JamesNewton/HybridDiskEncoder/firmware/readme.md

Hybrid Encoder Firmware

Ver 0.1 Connect via serial terminal 115,200 N81, 
 - 's' shows sin, cos, and ATAN2
 - '8' sin LED drive up '2' sin LED drive down
 - '6' cos LED drive up '4' cos LED drive down

TODO: Setup a timer and just output ATAN2 regularly
