JamesNewton/HybridDiskEncoder/docs/AreaRectCircle.png

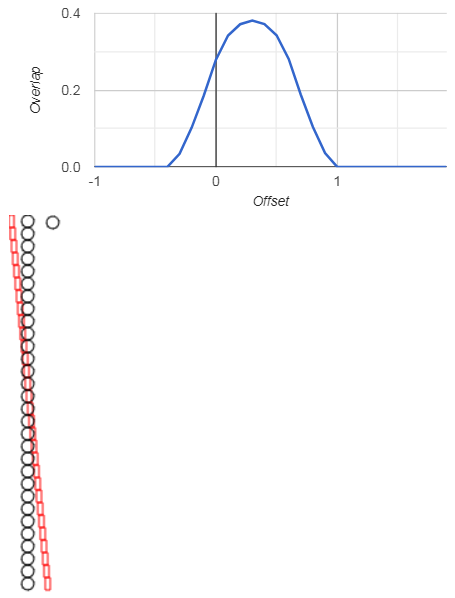
docs/AreaRectCircle.png
