JamesNewton/HybridDiskEncoder/(threads)

Thread 1 (2018-12-03):

Need to compute the arc tangent of the sensor inputs.

JamesNewton, 2018-12-03:
Possible guide
http://www.coranac.com/documents/arctangent/

JamesNewton, 2019-11-04:
http://scolton.blogspot.com/2019/09/fast-atan2-alternative-for-three-phase.html

JamesNewton, 2024-10-25:
Done for now with the standard math.h atan2 which seems to work fast enough. If we need more speed in the future, we can revisit.
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

JamesNewton, 2024-10-25:
Better scaling of the output
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

Closed 2024-10-25.

Thread 3 (2019-02-20):

Rectangular slits make square eyes, not round.

JamesNewton, 2019-02-20:
So the point of this is to get a round "eye" or circle when you plot the two sensors as X and Y on a graph. But that requires that the two sensors each put out a sin wave. It turns out that when the mask and slots are both rectangles, the resulting waveform is more of a triangle or a trapezoid, depending on their relative size.

Fig. 1: Rectangle passing over rectangle.<br>
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

Fig. 1: Rectangle passing over circle.<br>
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

The question of what shape results when you plot the area of intersection between two shapes out of phase on X and Y graph was interesting so I wrote a program to simulate it:
https://stackblitz.com/edit/enc-slot-shape-area
(change the code in any way to reload if you get an error about google not being defined). It's a bit of a mess because I started with rectangular shapes only and then added support for polygons to approximate any shape.

It's node.js so here is the package.json file
````json
{
  "name": "enc-slot-shape-area",
  "version": "0.0.0",
  "private": true,
  "dependencies": {
    "google-charts": "2.0.0",
    "greiner-hormann": "1.4.1",
    "polygon-clipping": "^0.12.2"
  }
}
````

And the actual program, index.js
````javascript
// Import stylesheets
import './style.css';
import {GoogleCharts} from 'google-charts';
import polygonClipping from 'polygon-clipping'

const poly1 = [[[0,0],[2,0],[2,2],[0,2],[0,0]]]
const poly2 = [[[0.1,0],[2.1,0],[2.1,2],[0.1,2],[0.1,0]]]

console.log(polygonClipping.intersection(poly1, poly2 /* , poly3, ... */))

// Write Javascript code!
const appDiv = document.getElementById('app');
//appDiv.innerHTML = `<h1>JS Starter</h1>`;
GoogleCharts.load('current', {packages: ['corechart', 'line']});
var data = new google.visualization.DataTable();
data.addColumn('number', 'X');
data.addColumn('number', 'Area');
//      data.addColumn('number', 'Cats');

function areaOverlapRect(shape1, shape2, inc) {
  var l1x=shape1.x+inc
  var l1y=shape1.y
  var r1x=shape1.x+shape1.w+inc
  var r1y=shape1.y+shape1.h
  var l2x=shape2.x
  var l2y=shape2.y
  var r2x=shape2.x+shape2.w
  var r2y=shape2.y+shape2.h
  var width = Math.max(Math.min(r1x, r2x) - Math.max(l1x, l2x),0)
  var height = Math.max(Math.min(r1y, r2y) - Math.max(l1y, l2y),0)
  return  width * height;
  }

//Area of polygon
//https://www.mathopenref.com/coordpolygonarea2.html

//Intersection of 2 polygons
//https://github.com/mfogel/polygon-clipping
function areaOverlapPoly(shape1, shape2, inc) {
  var total = 0
  var poly = []
  shape1.points.forEach((e,i) => {poly.push([e[0]+inc,e[1]])})
  var clip = polygonClipping.intersection([poly], [shape2.points] )
  //console.log(clip)
  if (!clip.length) {
    console.log("no intersection")
    return 0
    }
  clip = clip[0][0] //polygon-clipping returns burried array
  for (var i = 0, l = clip.length-1; i <= l; i++) {
    var addX = clip[i][0];
    var addY = clip[i == l ? 0 : i + 1][1];
    var subX = clip[i == l ? 0 : i + 1][0];
    var subY = clip[i][1];

    total += (addX * addY * 0.5);
    total -= (subX * subY * 0.5);
    }
  //console.log(total)
  return Math.abs(total);
  }

function areaOverlap( shape1, shape2, inc) {
  if(shape1.type != shape2.type) {
    console.log("only support same type")
    return null
  }
  if(shape1.type == "rect") return areaOverlapRect( shape1, shape2, inc)
  if(shape1.type == "poly") return areaOverlapPoly( shape1, shape2, inc)
  }

function drawPolyAtScaleCanvas(poly, x, y, scale, ctx) {
  ctx.beginPath();
  ctx.strokeStyle = poly.color;
  ctx.moveTo(scale*poly.points[0][0]+x, scale*poly.points[0][1]+y)
    for (var i in poly.points) { //re-does point 0 but who cares?
      ctx.lineTo(scale*poly.points[i][0]+x, scale*poly.points[i][1]+y)
      }
  ctx.stroke();
  }

function drawRectAtScaleCanvas(rect, x, y, scale, ctx) {
  ctx.beginPath();
  ctx.strokeStyle = rect.color;
  ctx.moveTo(scale*rect.x+x, scale*rect.y+y);
  ctx.lineTo(scale*(rect.x+rect.w)+x, scale*rect.y+y);
  ctx.lineTo(scale*(rect.x+rect.w)+x, scale*(rect.y+rect.h)+y);
  ctx.lineTo(scale*rect.x+x, scale*(rect.y+rect.h)+y);
  ctx.lineTo(scale*rect.x+x, scale*rect.y+y);
  ctx.stroke();
  }

function drawShapeAtScaleCanvas( shape, x, y, scale, ctx) {
  if(shape.type == "rect") return drawRectAtScaleCanvas(shape, x, y, scale, ctx)
  if(shape.type == "poly") return drawPolyAtScaleCanvas(shape, x, y, scale, ctx)
  }

var c = document.getElementById("myCanvas");
var ctx = c.getContext("2d");

var shape1 = {x:0, y:0, h:1, w:.5, color: "red", type: "rect"}
var shape2 = {x:0, y:0, h:1, w:.2, color: "blue", type: "rect"}
var mask = 0.4
const poly = {points:[[0,0],[mask,0],[mask,1],[0,1],[0,0]], color:"red", type:"poly" }
var circles = {points:[], color:"black", type:"poly"}
for (var i = 0; i<Math.PI*2; i+=.5) {
  circles.points.push([(Math.cos(i)+1.001)/2,(Math.sin(i)+1.001)/2])
  }
circles.points.push(circles.points[0])
drawShapeAtScaleCanvas(circles, 30, 1, 10, ctx)
shape1 = poly
shape2 = circles
//console.log(areaOverlap( shape1, shape2, 0 ))
var viewScale = 10
var area
var line = 0
for (var i=-1; i<2; i+=0.1) {
  drawShapeAtScaleCanvas(shape1, (i+1)*viewScale, line*viewScale, viewScale, ctx)
  drawShapeAtScaleCanvas(shape2, 1*viewScale, line*viewScale, viewScale, ctx)
  line += 1
  area = areaOverlap( shape1, shape2, i )
  //console.log( Math.round(area*1000)/1000 )
  data.addRows([[i,area]])
  }
var chart = new google.visualization.LineChart(document.getElementById('chart1'));
var options = {
  hAxis: {
    title: 'Offset'
  },
  vAxis: {
    title: 'Overlap'
  },
  series: {
    1: {curveType: 'function'}
  }
};
chart.draw(data, options);
````

JamesNewton, 2023-02-28:
Actually, it turns out that a circle is not the ideal shape. It's much better, but not perfect. The perfect shape is actually sort of an inside out circle.

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

```js
var jw = { points: [], color: 'black', type: 'poly' };
for (var i = 0; i < Math.PI * 2; i += Math.PI / 8) {
  let x = i >= Math.PI ? Math.PI * 2 - i : i; //over to the right, then back
  x /= Math.PI * mask; //scale to the size of the mask
  jw.points.push([x, (Math.sin(i) + 1.0001) / 2]);
}
jw.points.push(jw.points[0]); //close the path
```
The difference is subtle and may not actually matter in operation, but if possible, this code should be added to the project.

Closed 2019-02-20.

Thread 5 (2024-10-21):

Absolute position

JamesNewton, 2024-10-21:
Just being able to find position inside each slot doesn't tell us which slot we are in.

Single Track Grey Codes would allow us to know that with only one extra track. A new file has been added which incorporates this ability. It needs to be merged into the main file and holes for the sensors added to the support plate.

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

JamesNewton, 2024-10-26:
STGC now incorporated into the full assembly. Still need to add holes in the base plate for the sensors

JamesNewton, 2024-11-19:
Changed the setup to use the washer under the disk as a white paper STGC mask against the black primary slot disk with slots for the sensors in the base plate.
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

The sensor we are trying first is the [OPB702](https://www.mouser.com/datasheet/2/414/OPB702-3241541.pdf)
```
var stgcsens = square({size:[4.78, 12.2], center: true})
```
the idea is to partially stick the sensor into the base so that the focal point is about right. It wont take the full depth of the sensor for the normal mount, but just the little bit of the sloped part near the slot.
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

JamesNewton, 2024-12-16:
From the datasheet at:
https://www.mouser.com/datasheet/2/414/OPB702-3241541.pdf

VF Forward Voltage (Infrared LED) ‐ ‐ 1.7 V when IF = 20 mA
IR Reverse Current ‐ ‐ 100 µA when VR = 2 V

From any basic USB supply I have a lot of current (a couple amps) at 5 volts, and about 0.2 amps at 3.3 volts from the Pi Pico's onboard regulator.

The number of LEDs is generally fixed, but may change. Probably 7 for now, but it might be 6, 7, 8 or 10.

So my first dumb idea is to connect them in series and add up the voltage drops which are 1.7 volts each. So I can run like 3 in a chain from the 5 volt rail: 5/3 is 1.666 volts. But that doesn't work well because I want 7 LEDs total. If I wanted 6 (or any multiple of 3) it would be just perfect.

But I'm not 100% certain I want 7... I might want 6 or 8 in the future. If it were 9... but it will never be nine. It will be 6, 7, 8 or 10. Probably 7. If I go to 6, I will revisit the serial chain.

So, better option, run each with its own current limiting resistor. Resistors don't cost anything, effectively. R = (Vsupply - Vf) / If; For 20mA and 1.7 Vf that is (5-1.7)/0.02 = 165 ohms. So pairs of 330 ohm resistors, or perhaps a single 220 would be good enough?

Ok, actual questions:
1. Am I missing a trick? e.g. the individual resistor / LED pairs are best?
2. Would a 220 work? Or do I really need to burn two 330s? Testing is in order.

JamesNewton, 2024-12-18:
Updated the STGC Explorer to put out C code to initialize an array with the position for any read index.

It should be possible to read all the GPIOs with [gpio_get_all](https://www.raspberrypi.com/documentation/pico-sdk/hardware.html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)
`static uint32_t gpio_get_all (void)`
and then extract just the ones we want. The order isn't documented, but we assume it returns values in order of GPIO number? Time will tell. As long as we get the bits we want all in one lump, it's easy to extract them.

Thread 6 (2024-10-21):

Larger hub

JamesNewton, 2024-10-21:
Since the importance of cable / hose passthrough can't be understated, adding support to the development rig for a larger hub is probably a good idea. Not sure how to mechanically attach it; the current bolt is pretty easy and I'm not sure how to do that in a simple way.

JamesNewton, 2024-10-26:
Closed by [c142de4](https://github.com/JamesNewton/HybridDiskEncoder/commit/c142de4817cbbdded91df4807597f7471fb8729f)

Closed 2024-10-26.

Thread 7 (2024-12-03):

information on leds and photodiodes used

AldrickPeter, 2024-12-03:
Hello sir,
me and my friend are trying to make the hybrid disk encoder for a SCARA for our final year engineering project. We tried and tested a few components and we can never get it right. Please tell us the specs of the led and the photodiode that you used or even the component name.
Thankyou

JamesNewton, 2024-12-04:
Glad to see someone trying! I've added the info in the Electronics section in the read.me
https://github.com/JamesNewton/HybridDiskEncoder?tab=readme-ov-file#electronics

Whatever you do, start with just one connected, use a light source that it can see, and just watch the output of the ADC via the serial monitor until you have a good signal there. It's easy to get the sensor connected backwards, or have the trim pot set wrong, or to just wire it incorrectly. Take small steps, verify along the way. I started with just the trim pot voltage divider, with one side to ground, the other to 3.3, and then turned the knob until I saw a changing value in the ADC. Turns out I was 1. monitoring the wrong pin, 2. Didn't have the ground pin actually connected. Then I replaced the jumper to 3.3 with the photodiode and setup a slow flashing light until I got that signal through. I 100% had it connected backwards when I started. Here is the video of the first test setup
https://photos.app.goo.gl/wynsWwThrSx9u5cn8

AldrickPeter, 2024-12-04:
Sir, thank you so much for taking the time to put all this together! I am grateful for your generosity in sharing your knowledge and experience. It has been a huge help for me! Thank you!! 🙏🙏

JamesNewton, 2024-12-05:
@AldrickPeter Please do let me know how it goes: JamesNewton@MassMind.org

Closed 2024-12-04.

Thread 8 (2024-12-04):

Count slots along with position in slot

JamesNewton, 2024-12-04:
Just add standard quadrature encoding for now until we have STGC

JamesNewton, 2024-12-04:
Closed via ff9be278474bbda9fe5d8952b3499ce4081b4d2c

Closed 2024-12-04.

Thread 9 (2024-12-15):

Making a test joint to validate control loop improvement

JamesNewton, 2024-12-15:
The encoder provides a capability that I believe is not well understood in control systems. First some background:
- Control loops take in a commanded desired position or motion and read the current position (hopefully of the output shaft / joint rather than the motor shaft) then send commands to the motor driver (irrespective of the type of motor / driver) to correct the error; bringing the joint to the desired position or motion.
- Standard control loops, in order to accomplish this goal effectively, need to account for the physical attributes of the load, such as inertia, friction, etc... For example the I and D terms in the standard PID loop compensate for ongoing positional error (Integral) and future overcorrection (Derivative). Feedforward, input shaping, etc... all need to understand those attributes accurately in order to compensate for them.
- Robotics, especially, make understanding the physical attributes nearly impossible, because they keep changing. Picking up a load, changing orientation, etc... all completely rearrange the control system inputs making tuning a nightmare. This is true for many applications, but not all. e.g. input shaping is great for cartesian 3D printers because the load isn't changing. But on a router, the load when cutting is not the same as the load when doing a rapid.
- A control loop that doesn't need to understand the load is valuable.

Why don't the joints on the Dexter robot oscillate over a wide range of loads? Good question. I've spent years trying to understand it. I think there are two answers:

1. **Rate vs Force output** The output goes to a rate generator which steps a stepper motor. Most PID systems send a voltage to a DC motor. This represents a _force_ based control vs a _velocity_ based control. This makes the I term in the PID control redundant. The output as a velocity just regulates the speed of the correction; faster when the error is large, slower as the error decreases, but never going to zero until the position is perfect. Compare that to a force based output, where there is no force unless there is some positional error.

2. **Encoder sensitivity** The need for a D term (derivative, prediction of the future) or other "thinking ahead" type compensations increases as the _time_ required for the control loop to react increases. If your control loop is slow, you need better predictions to avoid under or over compensation. But the converse is also true: If your control loop is fast, you don't need to rely on those predictions as much. You can compensate for an error quickly, before it gets out of control. I was told for years that the FPGA is what made that speed of correction possible, but recently, I've had a revelation: _The time it takes for a change in position on the joint to be reported by a low CPR encoder absolutely swamps any other time delays in the system._ It's the `encoder` having a stunning CPR (over 100,000 CPR) that speeds up the loop!

To validate (or disprove) this idea, I need a better physical rig for testing: One that has not only an encoder operated by hand, but a full joint with links to attach loads, a transmission, gearbox, motor, and motor driver. And if that's going to happen, there are some features I think it should have:

- **Passthrough** Not a joint shaft, but a tube, with a space in the center to pass through wires, air, optics, or whatever. The larger diameter also helps with stability.
- **Enclosure** A strong metal box which the rotating tube passes through which can contain the encoder disk and sensing electronics which protects them from _electrical noise_, _optical interferrence_, _dust_, and _mechanical damage_. These are the weakest, most sensitive parts of the joint and the wires and disk were always getting damaged, gunked up, and the signals were noisy. This noise might be important, but controlling it is best; it can be added back on purpose if needed. This box would be easy to mount the lower link to and would need to hold the tube securely without mechanical slop in any dimension. Mechanical deformation and slop was a horrible problem on the robot.
- **Cross roller bearings** To mount the tube to the box, 45 degree "cross" roller bearings or needle bearings are important to avoid slop in any dimension. Standard bearings do not manage axial load well.
- **Flange** To attach the upstream link, the tube needs a strong, large, flange on either end.
- **Agnostic drive coupling** The method of driving the joint constantly changed during the design of the robot, but was always inbuilt into the design, meaning any change required re-design. Instead, the outside of the tube flange should support attachment of any of the following: Pulley, sprocket, cable spool, bevel gear, driven worm gear, etc... Outer mounting will make changing this simple.
- **Separate drive** Instead of including the electrically noisy, dirty, and heavy motor and gearbox in the joint box, they should be mounted in a separate metal box, which is easily attached directly to the joint box, or separately mounted along a link. This box should contain the motor, motor driver, power connections, control connector, gearbox and an output shaft with matching flange for all the above mentioned drive transmission possibilities.

cfry, 2024-12-16:
Just a nit pick:
"the load when cutting is not the same as the load when doing a rapid."
should _probably_ be
the load when cutting is not the same as the load when doing a rapid motion.

JamesNewton, 2024-12-21:
Ideas for test hardware:
- "Cheese plates" are basically cheap, little optical breadboards for camera gear. An easy and portable platform for building.
- Plumbing "faucet extension adapters" are available with threads on the outside and about a 1/2 inch hole in the middle. They also have flange(ish) nuts which should work to hold the encoder disk and perhaps pack the cross roller bearings into the sides. I also found these [generic parts](https://www.ebay.com/itm/186674139277), but only from the one source. Not sure how to keep them centered in the bearings; a "ramp" on the ID of a nut which drives into the center of the bearing? I can't seem to find an industrial source for a tube (not a rod) threaded on the outside. McMaster has "Hollow Threaded Stud" but the threads stop in the middle.
- Crossed Roller Bearings are /crazy/ expensive. It might be worth starting with bushings, but I really want to avoid stiction as it messes up the graphs. Perhaps the best option is combining a standard roller bearing with a flat thrust bearing as these are not terribly expensive.

cfry, 2024-12-22:
"Crossed Roller Bearings are /crazy/ expensive."
Is this due to current supply chain issues or that's always been true?
If the former, not so bad for a few to experiment with but
long term, you know I like low cost.

On Sat, Dec 21, 2024 at 1:55 PM JamesNewton ***@***.***>
wrote:

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

JamesNewton, 2024-12-23:
Thanks to the promise of a kind donation, I've ordered the bearings listed above. I'm looking for a local supplier of the ebay threaded tubing and flange nuts, but I'll probably just order those as they are not expensive and /sometimes/ stuff from China comes quickly, but if I order it now, it will get here before the end of time.

I'm still looking into components for the box. Some of these "cheese plates" have holes on the /edges/ which means they could be attached as the /sides/ of a box made with a cheese plate bottom.
https://www.amazon.com/CAMVATE-Cheese-Monitor-Mounting-Socket/dp/B0918YTKLS/ref=sr_1_25

Here is another, larger, one, which could be the base plate, but with holes on the side where a smaller regular plate could attach to make the sides. 
https://www.amazon.com/dp/B06XXLWYK7/ref=sspa_dk_detail_3 

And then maybe just a sheet steel or clear plastic cover on top. For the final product, it should be a closed up box to avoid light pollution and dust, but for a demo / development version, it's fine if it has holes and lets some light / dust in. The holes won't admit electrical noise (faraday cages are often just metal screens). 

JamesNewton, 2025-01-02:
The "Generic Pipe Adapter" has an OD slightly larger than the ID of the bearings, so to grind down those threads, the old trick of spinning it with a drill while grinding with a dremel is used. Chucking the pipe isn't possible in a simple drill, or drill press (it would need a lathe chuck) so a 3D printed spindle adapter can be used:

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

Note that the fn parameter is reduced on the outer diameter to provide high points which can be mashed down, and set to 6 on the inner diameter to mate with a hex drive. Then a philips or star bit can be inserted with the hex drive in the plastic, and the (round) bit shaft in the drill chuck.

```
// title      : Tube Turning Spindle
// author     : James Newton
// license    : MIT License

var len = 10
var rad = 14.62

function main () {
  return difference(
      cylinder({
          r1: 14.67/2
        , r2: 14.57/2
        , h: len, center: true, fn:20}
        ),
      cylinder({r: 6.3/2, h: len, center: true, fn: 6})
  ).translate([0, 0, len/2]);
}
```

JamesNewton, 2025-01-05:
I've realized that finding a cheese plate with a hole large enough to support this tube is not going to be possible, so I'm switching to using pillow bearings. These have a nice set screw and are the same size ID.
https://www.amazon.com/dp/B0BTNCJV47
I think I can more easily hack out the slot in the bottom of this cheese plate so the encoder disk can dip down into it
https://www.amazon.com/dp/B06XXLWYK7
or raise these a bit with something on the side, like these maybe:
https://www.amazon.com/dp/B01NCK79G2
by hacking them up into smaller blocks and stacking them.

I really wish there was a competent fabricator in the area who could work with metals. I don't want to use plastics because plastic is plastic, and I want something stiff to ensure I'm really reading the position of whatever link I connect and not the deformation of the joint mount.

JamesNewton, 2025-01-18:
Starting to come together: 3D printed flanges (See the flange.jscad file) to hold the lasercut disk. Next I have to figure out how to mount the sensors. They will eventually be a ring, for the STGC, but maybe I'll start with only the sine / cosine for now?

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

cfry, 2025-01-18:
that picture clear as a bell. Good work!

On Fri, Jan 17, 2025 at 10:50 PM JamesNewton ***@***.***>
wrote:

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

JamesNewton, 2025-03-10:
It has taken _forever_ but I'm finally making progress on this again. I've switched to a metal tube which I had turned down by a friendly local machinist on his lathe so that it would fit in the bearing blocks. Also, the blocks don't actually hold the bearings firmly, so I had to add another block to support the tube on both sides. Grinding open the inside of the plumbing flange to fit, then drilling and tapping for set screws to hold it against the shaft took (again) far longer than it should have. I am really a bad fabricator.

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

But now I can add a 3D printed pulley, lasercut a new disk, print an opto block that will mount at the bottom, figure out how to mount a stepper (probably to the underside to save having to buy a larger cheese plate) and then... then... I can validate the operation of the encoder / control system as a servo. And finally, move on to building a real servo, with a joint box, drive box, etc... as described under "Mechanical Design" above.

P.S. MANY THANKS to Fry for his help in acquiring the parts and tools for this.

cfry, 2025-03-11:
The image lof your construction looks pretty good to me.
Just like "programming" we need
"end user fabrication" !
A lot of the work is in, guess what, user interface.

On Mon, Mar 10, 2025 at 3:49 PM JamesNewton ***@***.***>
wrote:

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

JamesNewton, 2025-04-05:
3D printed a pulley using the attached OpenSCAD design which is modified from this old script I wrote many years ago:
[timingPulley-v5.scad.txt](https://github.com/user-attachments/files/19617975/timingPulley-v5.scad.txt)

I have a super long G2 belt that I will cut and attach around that, so I need to figure out some way to secure the ends into the pulley. It doesn't need to rotate more than 180' so I think I'm just going to hotmelt a set of threaded inserts into the side of the pulley and then screw down a... something... into that which holds the two ends of the belt, folded over. Some sort of... clamp... thing.... something that the back of the belt can fold back over, which won't move, and then something that will hold down the folded back bit, not allowing it to move. Like a strap buckle on a backpack. Or perhaps I can just punch a hole through the end of the belt and use a washer on a bolt into the threaded insert. Thinking...

cfry, 2025-04-06:
Anything that doesn't slip!
If there was a slot into the pulley interior that the
end of the belt could fit thru
then that end on the inside of the pulley got
glued or clamped somehow, that might work
as long as it didn't weaken the pulley too much.

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

JamesNewton, 2025-04-15:
Well, the stepper motor is mounted. I wasted a bunch of time trying to get store bought junk from China to work and ended up making a mount myself from a bit of old bed frame we were throwing out. Now I need a belt of the right length (probably 600mm) and then I can cut some slots and shorten the mount to fit.

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

JamesNewton, 2025-06-02:
A tiny bit of progress after far to long.

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

- The NEMA 23 stepper motor is mounted
- A pulley has been 3D printed and mounted to the joint shaft with a belt to the motor
- The 200W stepper driver has been pulled from a working project
- Headers with color pinout labels have been soldered to a new RasPi Pico and it's been placed in a soldered breadboard.

I think I will take it out of that breadboard PCB and put it in a longer one I have to give room for more connectors and spaces, but I generally really like that mounting. I can easily see the pin label from the outside, I can stick jumper wires in the top, or in the case of power and ground, I have an extra row on the bottom as well as the solder points which I will use to duplicate the existing encoder electronics in a more permanent form since I don't need to worry about changing that now. There is also just a bit of each header pin showing above the socket where I can clip on a scope or meter lead as needed.

cfry, 2025-06-02:
Very clean!

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

JamesNewton, 2025-09-20:
Finally making a bit of progress on the mechanical side (which I suck at) with a better belt tensioner.

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

The small pulley needs to be better attached to the motor shaft and I think a set screw will do that. Then I can focus on mounting the new encoder disk and the opto block and the reflective sensors for the STGC. Sigh.

cfry, 2025-09-21:
Pretty picture!
You need a belt tensioner because the belt stretches.
The advantage of a metal chain is it doesn't stretch, right?
But needs oil, is more expensive, and since it is heavier,
more energy to accelerate, is that right?
It shocked me the first time I saw a Harley with a belt
in place of a chain.

On Sat, Sep 20, 2025 at 7:17 PM JamesNewton ***@***.***>
wrote:

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

Thread 10 (2025-01-12):

test

JamesNewton, 2025-01-12:
test

JamesNewton, 2025-01-12:
DIGITAL FRICTION

Another method of avoiding oscillation is to simply stop driving the motor. That will 100% solve the problem. On the other hand, it will also stop the system from correcting positional errors.

Friction, or more specifically, stiction (the type of friction that happens when you aren't moving) can be simulated in a servo system by setting a level of error below which no force (or positional correction) is applied. Of course, the real stiction is based on force, and the error in position is only approximate to force based on the stiffness of the drive system.

JamesNewton, 2025-02-02:
There is usually more than one way to solve a problem. In the case of a servo system, the problem is "my current position is the same as my goal position." The obvious solution is "force the current position in the direction of the goal position", but there is another solution: "force the goal position towards the current position." At first blush, that seems a rather poor solution, but in fact, it has a certain brilliance to it when applied in cases were it has use.

If you split the error between the two solutions, attempting to move the current position towards the goal, but also adding an offset to move the goal towards the current, then one of two things will happen:
- if the joint isn't blocked, it will move towards the goal
- if the joint IS blocked, the goal will move towards the blockage, which prevents the joint over torquing.

JamesNewton, 2025-06-02:
CARTESIAN VS JOINT SPACE MOTION: All of the above is related to motion planning in joint space. If multiple joints are assembled between links to form an arm, or some other form, we need to think about the difference between the motion of the load at the end effector, and the motion at each joint which results in the motion of the load. For an XYZ robot like a traditional 3D printer, there is no difference. For Spherical / Polar, SCARA, or Cylindrical arms, simple trigonometry is enough. For the Anthropomorphic (aka Articulated) arm... the nightmare begins.

INVERSE KINEMATICS (IK): First, we need to understand what set of angles in joint space will bring the load to a given cartesian position. This is far more difficult than one might expect because of

1. SINGULARITIES: Where there are multiple valid answers e.g. holding the load in line with the axis of any one joint).

2. CONFIGURATIONS: Actually a type of singularity where the joints can be used in more than one combination to reach a goal. e.g. should the "elbow" bend upward or downwards?

3. INTERFERENCE: Where the combination of joints can't reach a position without hitting each other

4. INACCURACY: Where the arm isn't perfectly manufactured (none can be) and the errors accumulate and must be accounted for. E.g. DH parameters.

See also:
- https://github.com/HaddingtonDynamics/Dexter/wiki/Kinematics

TRAJECTORY PLANNING: Once we can convert a point in 3D space into a set of joint angles, we need to know which points to convert. Just doing the one at the goal and sending that can result in a motion with a number of problems:

1. COLLISIONS: The arm may collide with external objects or with itself. We must develop a path to ensure this won't happen... this assumes an accurate model of the objects around the arm and of the arm itself and of the load. This sounds simple, but becomes fantastically complex quickly. Many papers and solutions are available, but most are computationally extreme. Your good idea might change the world.

2. NON-LINEAR: As the joints rotate independently to the new set of goal angles, each may reach that goal at a different point in time. For example, if the goal is on the opposite side of the robot, and slightly lower, the J1 joint will probably take a longer time than the J2 or J3 joints. This can result in an unexpected path which is very much not a straight line between the current and goal positions. To correct this, we must first artificially slow down the joints which will need less time, and also provide interim points along the desired (linear) path. How many points? One method is to simply divide the desired path in half, do the IK for the new point, then compare the change in joint angles for each joint, and re-halve the path again if any joint changes more than a few degrees.

3. INERTIAL: But we also need to think about the mass of the load, and how it will be accelerated, ne: _jerked_ as it moves from point to point. So the goal _time_ for each point needs to be calculated along with the desired velocity, acceleration and jerk _through_ the point. This gets very complex very fast, and complicates the joint motion plan as mentioned above. Again, good solutions are rare, and it's easy to see why robotics would dearly love an AI solution. Perhaps you can setup an experiment that tries to teach a spatial transformer how to avoid jerking a load while moving it through a complex path?

Closed 2025-01-12.

Thread 11 (2025-03-02):

edge shape instead of slots

JamesNewton, 2025-03-02:
Instead of passing a slot between the light source and sensor, blocking and passing light with an edge that passes through the gap side to side, we can interrupt the light by changing how far the edge of the disk passes into the slot; blocking and passing light with an edge that extends into the gap, more or less. Imagine a disk with no slots, but an edge with a "ruffle" on it, or a very thin gear.

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

There would be several advantages:
1. Slots are more likely to hold gunk or fuzz causing a change in the light levels at that "eye"
2. The shape can probably be adjusted to produce the desired sine wave without a special mask ( see #3 )
3. Not needing the outside rim, means the disk can be a little smaller

The disadvantage is that the correct shape is difficult to calculate since it interacts in two dimensions instead of one. This is less of a problem when the number of "non-slots" on the disk are lower and the mask on the sensor is very narrow. However, fewer "non-slots" means lower resolution, and a narrow mask reduces light levels, lowering bandwidth, which again reduces resolution. So doing the work to calculate the correct shape is probably worth it.

It's also less structurally sound. Probably. Maybe not.
