JamesNewton/HybridDiskEncoder/firmware/HybridEncoder.cydsn/cyapicallbacks.h

/* ========================================
 *
 * Copyright YOUR COMPANY, THE YEAR
 * All Rights Reserved
 * UNPUBLISHED, LICENSED SOFTWARE.
 *
 * CONFIDENTIAL AND PROPRIETARY INFORMATION
 * WHICH IS THE PROPERTY OF your company.
 *
 * ========================================
*/
#ifndef CYAPICALLBACKS_H
#define CYAPICALLBACKS_H
    

    /*Define your macro callbacks here */
    /*For more information, refer to the Writing Code topic in the PSoC Creator Help.*/

    
#endif /* CYAPICALLBACKS_H */   
/* [] */
