JamesNewton/HybridDiskEncoder/(commit log)

2018-11-27 Update README.md
    The current system uses the level of the emitted light to control the amplitude of the signal.
2018-11-30 Update encoderdisk.jscad
    Make washers and risers thin vs thick
    Make washers larger, dropping support for bearings because having some friction is a good thing.
2018-12-04 Update encoderdisk.jscad
    Adjust hole sizes for sensors and LED, and slot width for mask, to compensate for lasercutter beam width / 3D printer spread.
    Set default hub hole size to M3.
    Set default material thickness to 3mm (standard Acrylic).
    Set default opaque thickness to 0.4mm (110lb card stock).
2018-12-05 Update encoderdisk.jscad
    Remove the fudge, THEN divide by 2!
    Add construction notes for lasers
2018-12-05 Update to match components
    Delete "masktop" and just keep one mask. It goes at the top, but only one is needed.
    Add LED holder below base. Needed because the LEDs are longer than the 3mm Plexi and they press into the disk,
    Add 1 additional riser to the cut list because cardstock compresses.
2018-12-15 Start PWM 1 (sin). Outputs are currently P1.6 (onboard LED) and P2.6
    Remove OpAmps from ADC 2 and 3 inputs. For some reason, they do not allow any input to pass through. Inputs now P2.2 ADC2 sin and P2.3 ADC3 cos
    Also collect ADC 0 and 1 inputs for debugging
2022-12-14 Better bin packing through rotation
    Manually hinting a rotation so that the thick parts pack better, and then switched to getBounds to figure out the width of all the thick parts and move them out of the way of the thin parts.
2024-10-26 Combine stgc and prior encoder
    - Now the number of slots is specific to the Single Track Grey Code, and that track is added inside the main slots
    - Fixed large hub size exceeds width of arm, support and riser.
    - Better alignment of parts for cutting.
    TODO: Cut holes in the base plate for the STGC sensors.
2024-11-03 Add quadrature decoding, slot counts
2024-11-06 Add standard quadrature decoding to the analog in-slot decoding
2024-11-09 facepalm
    Do not commit code changes when half asleep! I had committed the arduino code into the jscad file.
    Moved STGC to lower washer. Cutting that in white paper will give me a good contrast to sense the track via reflection.
2024-11-09 offset stgc sensors / disk to avoid LEDs
2024-11-19 change STGC sensor to OPB702
2025-01-16 Create flange.jscad
    First pass at a flange to hold the encoder disk to the threaded tubing for the servo experiment.
2025-01-17 add fudge factor
    Using exact numbers, it's a bit too tight because of filament expansion. Adding an adjustable fudge to increase the diameter of the hole and threads just a bit.
2025-01-17 More fudge, tabs
    Still needs to be a bit bigger, and added tab holes to make sure the disk doesn't rotate.
2025-09-14 Create belt_rider.jscad
    Needs a lot of work.
2025-09-14 Update belt_rider.jscad
    Progress. Not sure why the hull is so long.
2025-09-15 Update belt_rider.jscad
    Getting there...
2025-09-15 Update belt_rider.jscad
    Conditional view of assembly or print.
    Updated default values.
    Printing support
2025-09-16 Update belt_rider.jscad
    Better print support
    Allowance for clearance of bolt when making holes.
2025-09-18 Update belt_rider.jscad
    Better values, stop trying to do support, dial in the rider position changes.
2025-09-20 Update belt_rider.jscad
    Height was way off. Belt is further from the plate.
    Make room for the nut holding the mounting bolt to the plate.
2025-09-20 Update belt_rider.jscad
    mount bolt hole not shifted down.
2025-09-20 Update belt_rider.jscad
    Allow the bearings to be moved to the other side
2025-11-22 Adjust mounting thickness and bearing count
2025-12-23 TODO PCB slots / STGC disk
    Updated TODO list with new tasks and removed a completed task.
2026-11-01 Update disk and hub dimensions, add mask output
    To match the mount CADed by Curtis
2026-11-02 Refactor mask dimensions and translation logic
    Force the mask to align with the mount Curtis made
